Jayavsingh30/coil-winding-machine/Documentation/WhatsApp Image 2025-05-26 at 00.51.20_356be0d4.jpg

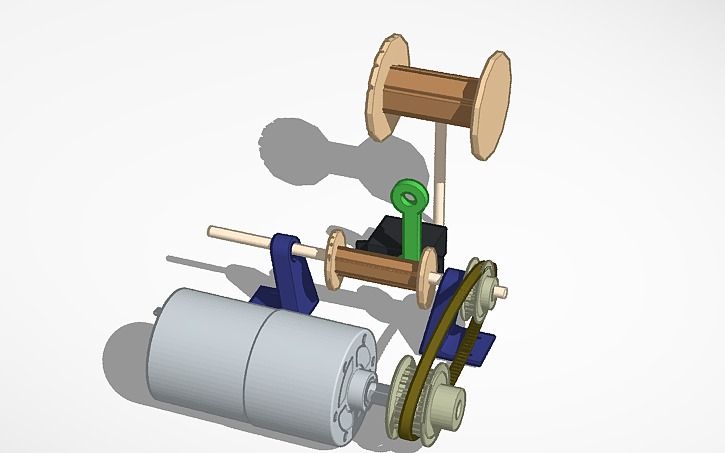
Documentation/WhatsApp Image 2025-05-26 at 00.51.20_356be0d4.jpg
