Jayavsingh30/coil-winding-machine/README.md

# coil-winding-machine
DIY automated coil winding machine with schematics, firmware, and documentation
