Jayavsingh30/coil-winding-machine/Documentation/Coil_Winding_Machine.pdf

# COIL WINDING MACHINE

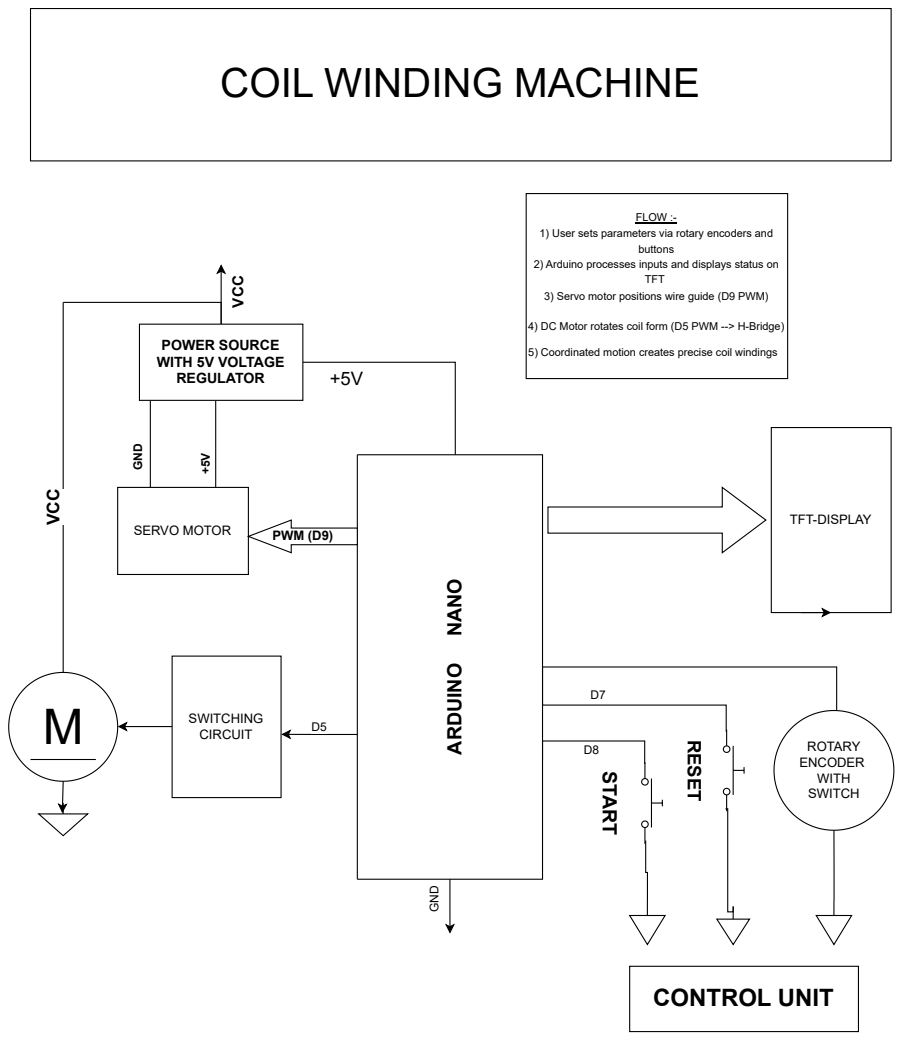
[picture p2: page 1]
GND; UIN; TFT-DISPLAY; SWITCHING CIRCUIT; VCC; SERVO MOTOR; PWM (D9); RESET; START; ROTARY ENCODER WITH SWITCH; CONTROL UNIT; POWER SOURCE WITH 5V VOLTAGE REGULATOR; FLOW :-; buttons; TFT

1) User sets parameters via rotary encoders and

2) Arduino processes inputs and displays status on

3) Servo motor positions wire guide (D9 PWM)

4) DC Motor rotates coil form (D5 PWM --> H-Bridge)

5) Coordinated motion creates precise coil windings

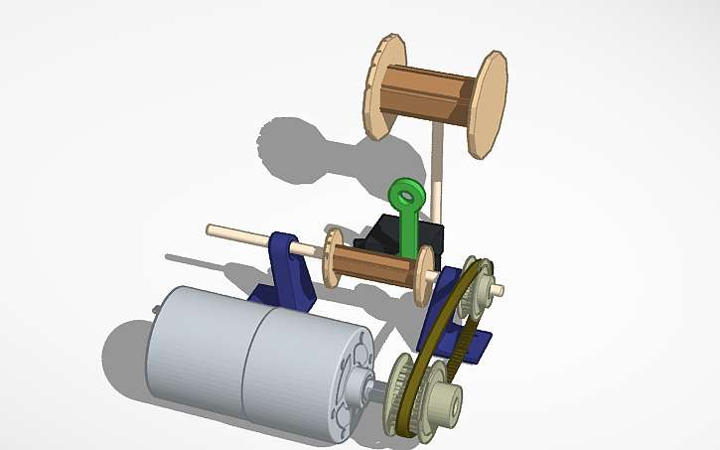
[picture p3: figure]
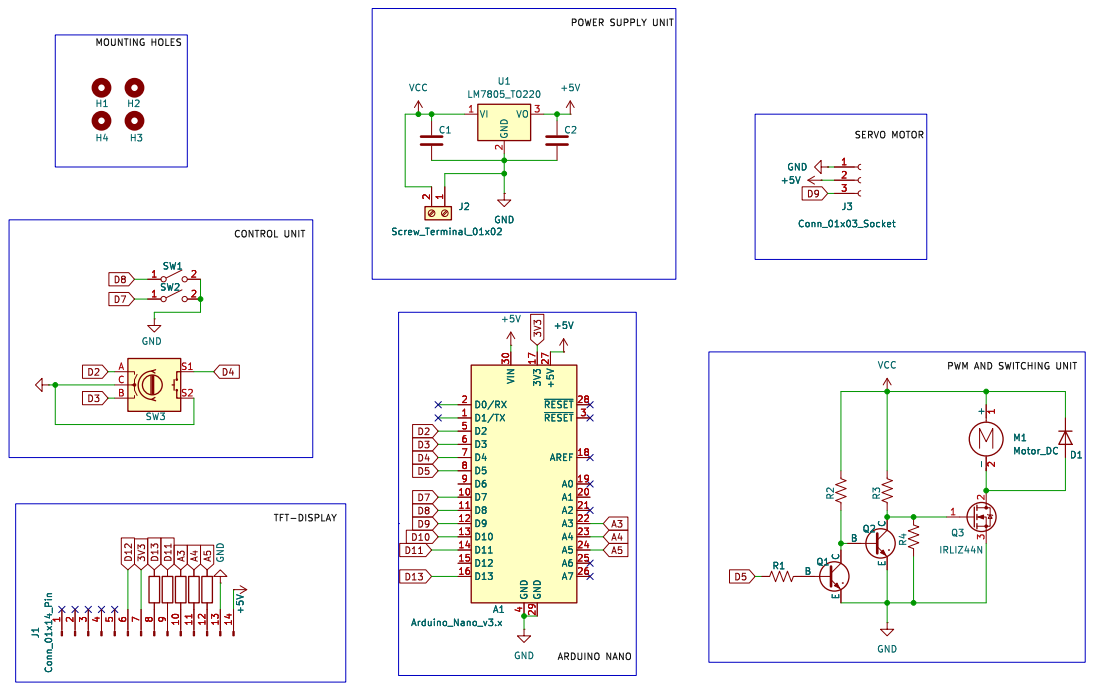
[picture p4: page 3]

## Bill of Materials (BOM)

Project: Coil Winding Machine | Date: 2025-05-26 | Revision: Rev. 1.0

### Section A - Mechanical Components

Sr. No | Part Name | Qty | Specification / Details | Notes
M1 | DC Motor | 1 | 775 DC Motor, 12-24V, 10000 RPM | Shaft: 5mm
M2 | Servo Motor | 1 | MG996R, 180deg Range, 15kg-cm | For lateral positioning
M3 | MDF Board | 1 | 11mm thick | Base structure
M4 | Timing Pulley (Motor) | 1 | 5mm bore, GT2 type | Mounted on 775 shaft
| | | 5mm bore, GT2 type
M5 | Timing Pulley (Load) | 1 | | Attached to winding mechanism
M6 | Timing Belt | 1 | GT2, 100mm length, 6mm width | Matches 20T-40T pulley combo
M7 | Ball Bearings | 2 | ID: 5mm, OD: 17mm, Width: 5mm | Deep groove type

### Section B - Electronics Components

Sr. No | Part Name | Qty | Specification / Details | Notes
E1 | Microcontroller | 1 | Arduino Nano (CH340 or ATmega328p) | Main control board
E2 | Custom PCB | 1 | Single-layer, 7050 mm | Hosts power, logic, and I/O
E3 | TFT Display | 1 | 2.8-inch SPI TFT, 240320 res | CS:A5, RESET:A4, DC:A3
E4 | Push Buttons | 2 | Tactile push buttons | For input controls
E5 | Rotary Encoder | 1 | With push button, D-shaft | Navigation + selection
E6 | MOSFET | 1 | IRF540N or equivalent | Controls DC motor via PWM
E7 | Transistors | 2 | NPN type | For motor control
E8 | Capacitors | 10 | 100nF, 10uF, 470uF (mix) | Filtering and stability
E9 | Resistors | 10 | 220Ohm, 1kOhm, 10kOhm (mix) | Pull-up/down and limiting
E10 | Diodes | 4 | 1N4007 | Flyback protection
| | | LM7805
E11 | Voltage Regulator | 1 | Power to logic and modules
