Jayavsingh30/coil-winding-machine/Hardware/Pcb/coil_winding_v1/coil_winding_step.pdf

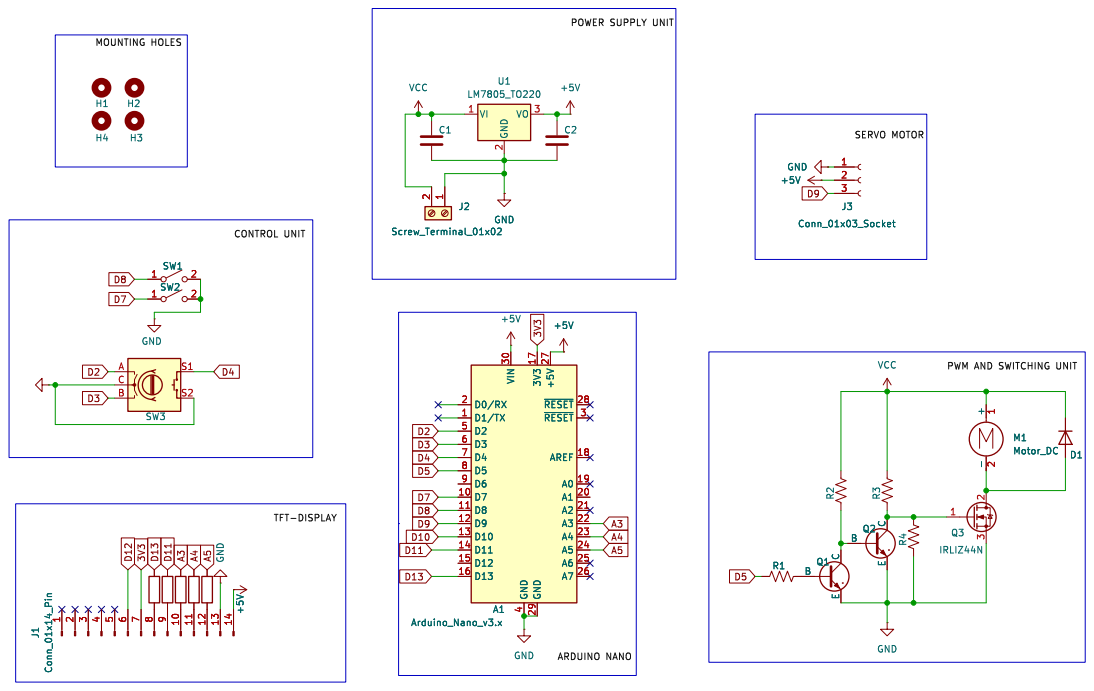
[picture p5: page 1]
