Jayavsingh30/coil-winding-machine/Hardware/Pcb/coil_winding_v3/compact/compact (2).kicad_pcb

## KiCad design Hardware/Pcb/coil_winding_v3/compact/compact (2).kicad_pcb (2025-06-27)

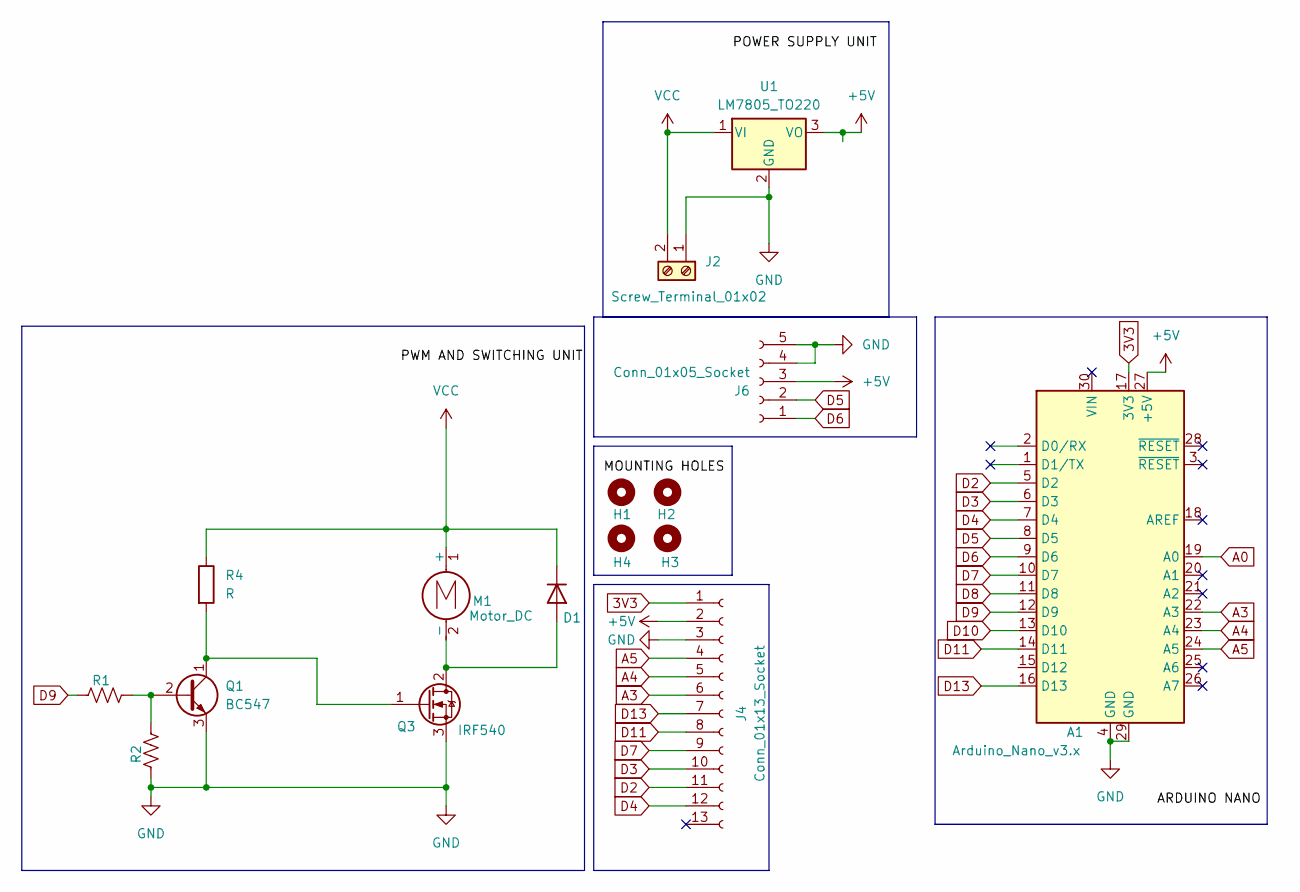
[picture p6: schematic compact (2).kicad_sch, COIL WINDING MACHINE]

Parts:
A1: Arduino_Nano_v3.x; Arduino_Nano
D1: D; D_DO-41_SOD81_P12.70mm_Horizontal
H1, H2, H3, H4: MountingHole; MountingHole_4mm
J2: Screw_Terminal_01x02; TerminalBlock_4Ucon_1x02_P3.50mm_Horizontal
J4: Conn_01x13_Socket; PinHeader_2x13_P2.54mm_Vertical
J6: Conn_01x05_Socket; PinHeader_2x05_P2.54mm_Vertical
M1: Motor_DC; TerminalBlock_4Ucon_1x02_P3.50mm_Horizontal
Q1: BC547; TO-92_Inline
Q3: IRF540; TO-220F-3_Vertical
R1: 220; R_Axial_DIN0207_L6.3mm_D2.5mm_P7.62mm_Horizontal
R2: 10K; R_Axial_DIN0207_L6.3mm_D2.5mm_P7.62mm_Horizontal
R4: R; R_Axial_DIN0207_L6.3mm_D2.5mm_P7.62mm_Horizontal
U1: LM7805_TO220; TO-220-3_Vertical

Connections:
3V3: A1.17 (3V3), J4.1
+5V: A1.27 (+5V), J4.2, J6.3, U1.3 (VO)
A0: A1.19 (A0)
A3: A1.22 (A3), J4.6
A4: A1.23 (A4), J4.5
A5: A1.24 (A5), J4.4
D2: A1.5 (D2), J4.11
D3: A1.6 (D3), J4.10
D4: A1.7 (D4), J4.12
D5: A1.8 (D5), J6.2
D6: A1.9 (D6), J6.1
D7: A1.10 (D7), J4.9
D8: A1.11 (D8)
D9: A1.12 (D9), R1.1
D10: A1.13 (D10)
D11: A1.14 (D11), J4.8
D13: A1.16 (D13), J4.7
GND: A1.4 (GND), A1.29 (GND), J2.1, J4.3, J6.4, J6.5, Q1.3 (E), Q3.3 (S), R2.1, U1.2 (GND)
unnamed: D1.2 (A), M1.2 (-), Q3.2 (D)
unnamed: Q1.2 (B), R1.2, R2.2
unnamed: Q1.1 (C), Q3.1 (G), R4.2

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
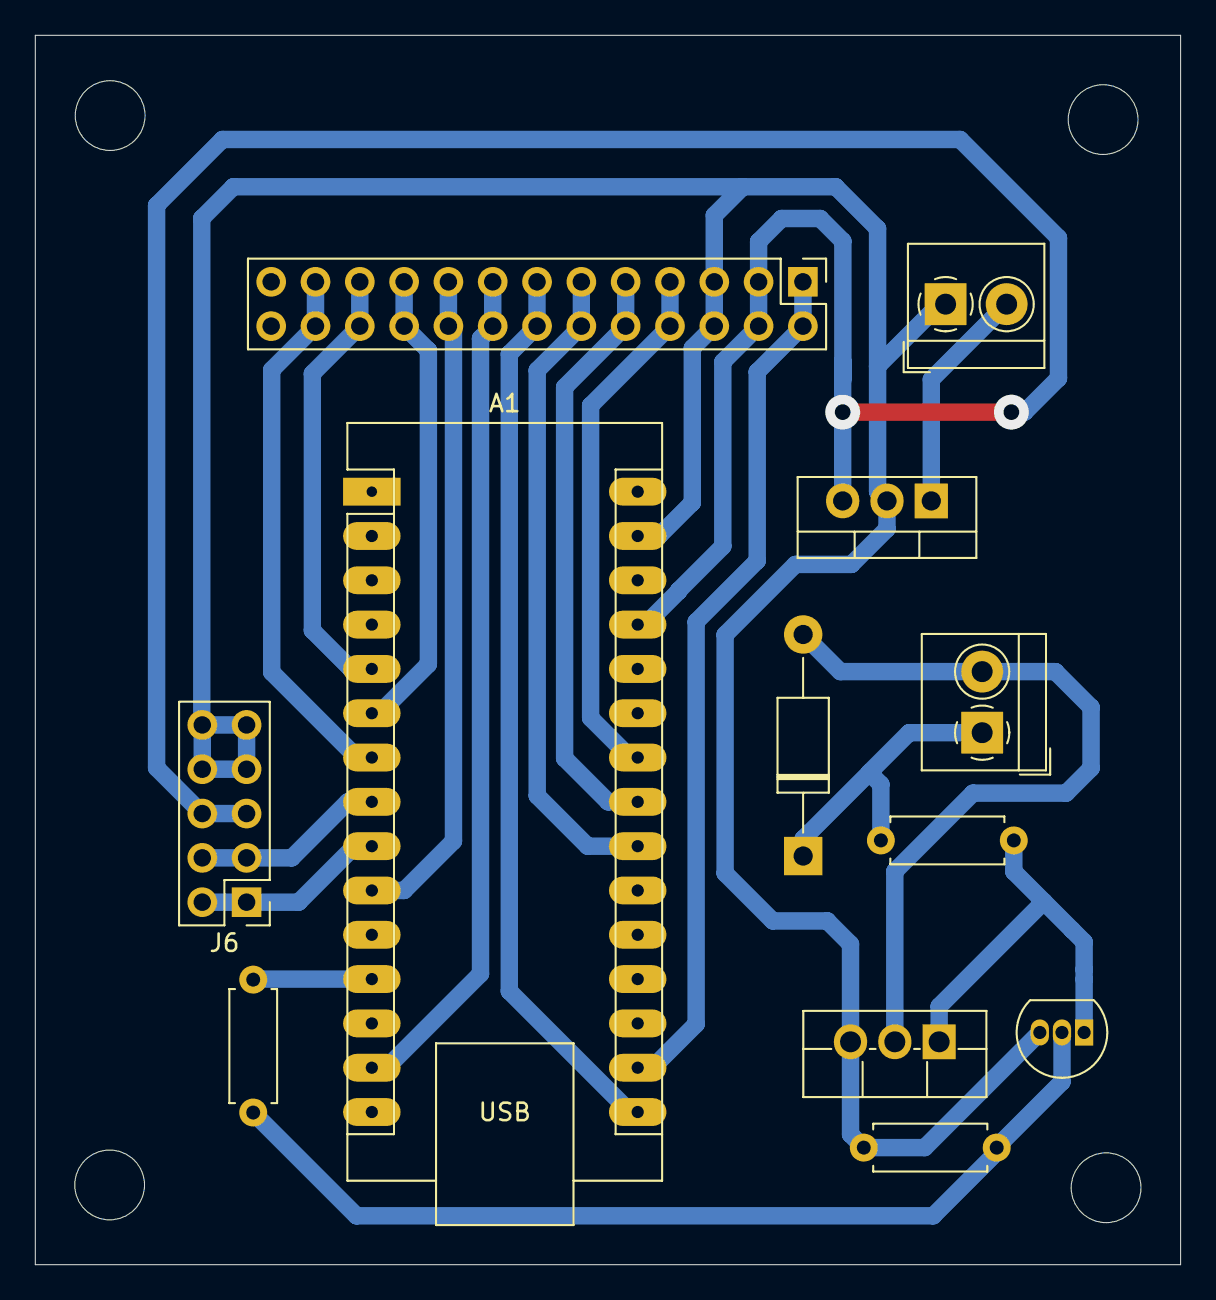
[picture p7: board compact (2).kicad_pcb from above]

Board: 2 copper layers, 65.7 x 70.5 mm, 16 parts (0 on the bottom side), 20 nets.
