Jayavsingh30/coil-winding-machine/Hardware/Pcb/coil_winding_v3/sensor/sensors/sensors.kicad_pcb

## KiCad design Hardware/Pcb/coil_winding_v3/sensor/sensors/sensors.kicad_pcb (2025-06-27)

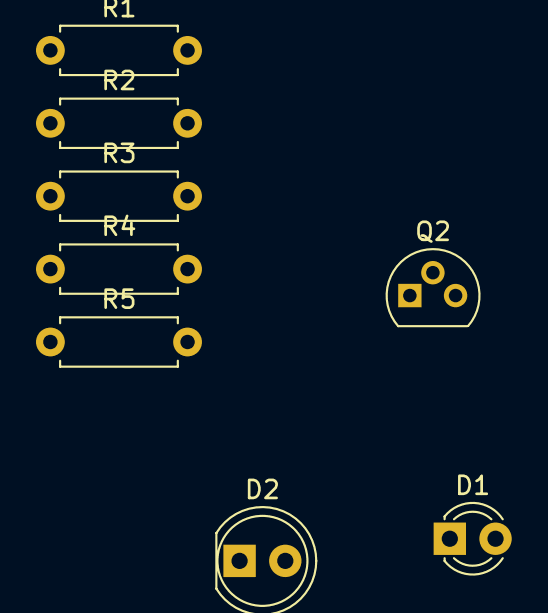
[picture p8: board sensors.kicad_pcb from above]

Board: 2 copper layers, 12 parts (0 on the bottom side), 7 nets, no tracks yet.

Parts:
D1: LED; LED_D3.0mm_Clear
D2: LED; LED_D5.0mm
H1, H2, H3, H4: MountingHole; MountingHole_3.2mm_M3
Q2: BC547; TO-92L
R1: 150; R_Axial_DIN0207_L6.3mm_D2.5mm_P7.62mm_Horizontal
R2: 2.2k; R_Axial_DIN0207_L6.3mm_D2.5mm_P7.62mm_Horizontal
R3, R4: 4.7k; R_Axial_DIN0207_L6.3mm_D2.5mm_P7.62mm_Horizontal
R5: 1k; R_Axial_DIN0207_L6.3mm_D2.5mm_P7.62mm_Horizontal

Connections:
+5V: D1.2 (A), R1.1, R3.1, R5.1
DETECT: R3.2, R4.1
GND: Q2.3 (E), R2.2
unnamed: D1.1 (K), R2.1
unnamed: D2.2 (A), R5.2
unnamed: D2.1 (K), Q2.1 (C)
unnamed: Q2.2 (B), R4.2
