Jayavsingh30/coil-winding-machine/Hardware/Pcb/coil_winding_v3/front_panel/front_panel.kicad_pcb

## KiCad design Hardware/Pcb/coil_winding_v3/front_panel/front_panel.kicad_pcb (2025-06-27)

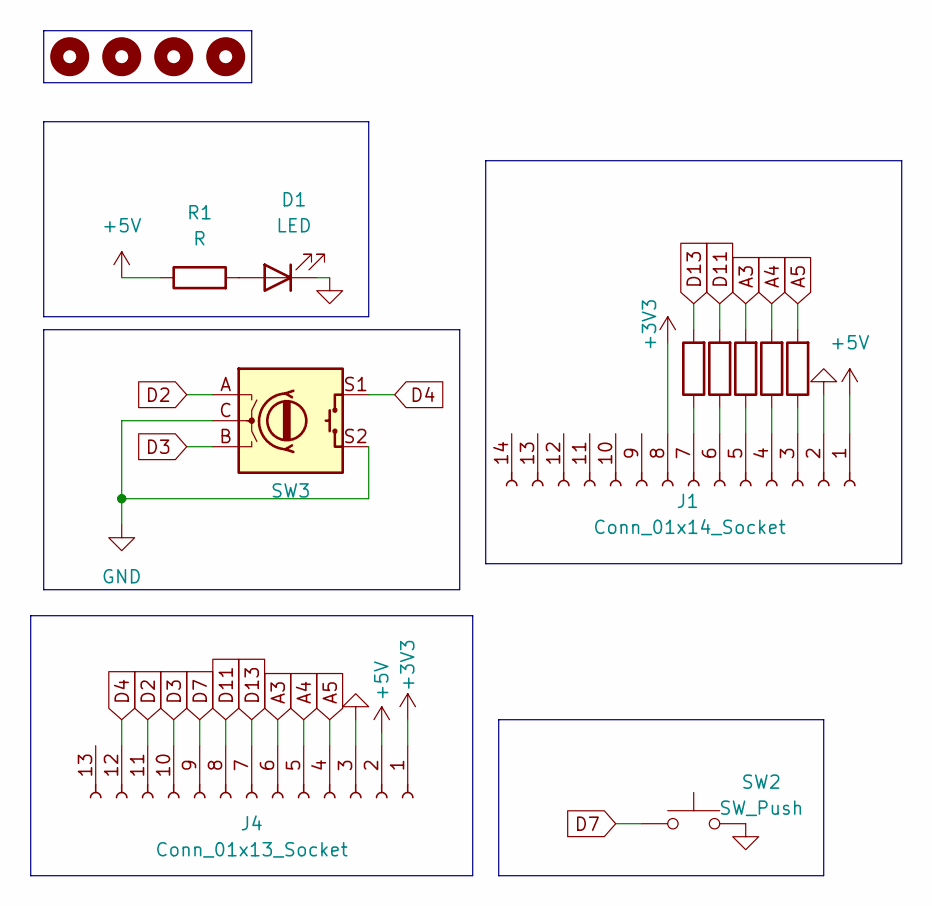
[picture p9: schematic front_panel.kicad_sch]

Parts:
D1: LED; LED_D5.0mm
H1, H2, H3, H4: MountingHole; MountingHole_3.2mm_M3
J1: Conn_01x14_Socket; PinSocket_1x14_P2.54mm_Vertical
J4: Conn_01x13_Socket; PinSocket_2x13_P2.54mm_Vertical
R1, R2, R3, R4, R6, R7: R; R_Axial_DIN0207_L6.3mm_D2.5mm_P7.62mm_Horizontal
SW2: SW_Push; SW_PUSH_6mm_H7.3mm
SW3: RotaryEncoder_Switch; RotaryEncoder_Alps_EC12E-Switch_Vertical_H20mm_CircularMoun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

Connections:
+3V3: J1.8, J4.1
+5V: J1.1, J4.2, R1.1
A3: J4.6, R4.2
A4: J4.5, R3.2
A5: J4.4, R2.2
D2: J4.11, SW3.A
D3: J4.10, SW3.B
D4: J4.12, SW3.S1
D7: J4.9, SW2.1
D11: J4.8, R7.2
D13: J4.7, R6.2
GND: D1.1 (K), J1.2, J4.3, SW2.2, SW3.C, SW3.S2
unnamed: D1.2 (A), R1.2
unnamed: J1.3, R2.1
unnamed: J1.4, R3.1
unnamed: J1.5, R4.1
unnamed: J1.6, R7.1
unnamed: J1.7, R6.1

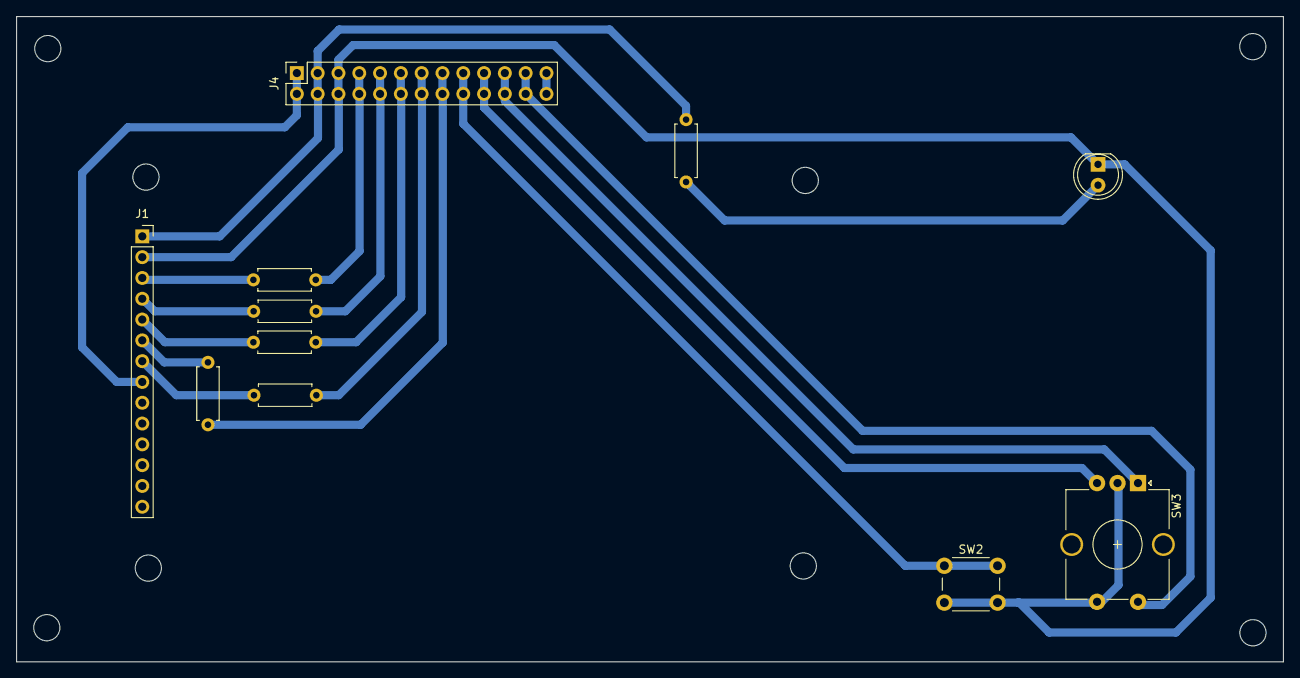
[picture p10: board front_panel.kicad_pcb from above]

Board: 2 copper layers, 154.7 x 78.8 mm, 19 parts (0 on the bottom side), 18 nets.

Other parts of the board:
H1#2, H1#3, H1#4, H1#5: MountingHole; MountingHole_3.2mm_M3
