Jayavsingh30/coil-winding-machine/Hardware/Pcb/coil_winding_v1/coil_winding_step.kicad_pcb

## KiCad design Hardware/Pcb/coil_winding_v1/coil_winding_step.kicad_pcb (2025-06-04, an earlier design)

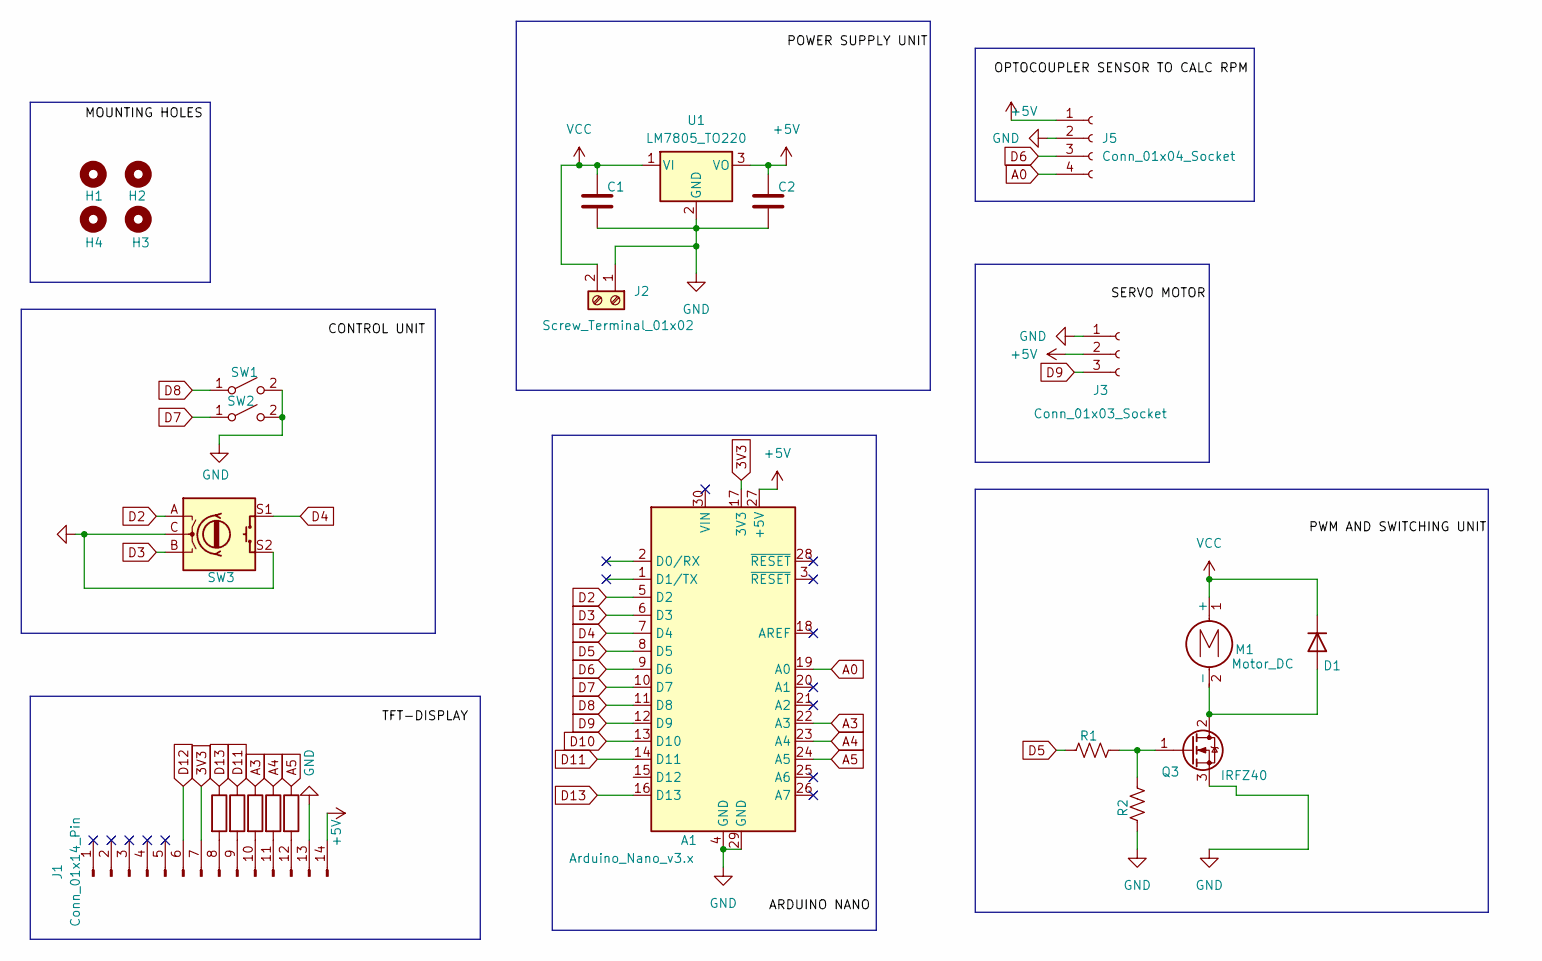
[picture p11: schematic coil_winding_step.kicad_sch, COIL WINDING MACHINE]

Parts:
A1: Arduino_Nano_v3.x; Arduino_Nano
C1, C2: C; CP_Radial_D5.0mm_P2.00mm
D1: D; D_DO-41_SOD81_P12.70mm_Horizontal
H1, H2, H3, H4: MountingHole; MountingHole_4mm
J1: Conn_01x14_Pin; PinSocket_1x14_P2.54mm_Vertical
J2: Screw_Terminal_01x02; BarrelJack_Horizontal
J3: Conn_01x03_Socket; PinSocket_1x03_P2.54mm_Vertical
J5: Conn_01x04_Socket; PinHeader_1x04_P2.54mm_Vertical
M1: Motor_DC; PinHeader_1x02_P2.54mm_Vertical
Q3: IRFZ40; TO-220F-3_Vertical
R1: 220; R_Axial_DIN0207_L6.3mm_D2.5mm_P7.62mm_Horizontal
R2: 10K; R_Axial_DIN0207_L6.3mm_D2.5mm_P7.62mm_Horizontal
R9, R10, R11, R12, R13: R; R_Axial_DIN0207_L6.3mm_D2.5mm_P7.62mm_Horizontal
SW1, SW2: SW_SPST; SW_PUSH_6mm_H7.3mm
SW3: RotaryEncoder_Switch; RotaryEncoder_Alps_EC12E-Switch_Vertical_H20mm
U1: LM7805_TO220; TO-220-3_Vertical

Connections:
3V3: A1.17 (3V3), J1.7
+5V: A1.27 (+5V), C2.1, J1.14, J3.2, J5.1, U1.3 (VO)
A0: A1.19 (A0), J5.4
A3: A1.22 (A3), R11.1
A4: A1.23 (A4), R10.1
A5: A1.24 (A5), R9.1
D2: A1.5 (D2), SW3.A
D3: A1.6 (D3), SW3.B
D4: A1.7 (D4), SW3.S1
D5: A1.8 (D5), R1.1
D6: A1.9 (D6), J5.3
D7: A1.10 (D7), SW2.1 (A)
D8: A1.11 (D8), SW1.1 (A)
D9: A1.12 (D9), J3.3
D10: A1.13 (D10)
D11: A1.14 (D11), R12.1
D12: J1.6
D13: A1.16 (D13), R13.1
GND: A1.4 (GND), A1.29 (GND), C1.2, C2.2, J1.13, J2.1, J3.1, J5.2, Q3.3 (S), R2.1, SW1.2 (B), SW2.2 (B), SW3.C, SW3.S2, U1.2 (GND)
unnamed: D1.2 (A), M1.2 (-), Q3.2 (D)
unnamed: J1.8, R13.2
unnamed: J1.9, R12.2
unnamed: J1.10, R11.2
unnamed: J1.11, R10.2
unnamed: J1.12, R9.2
unnamed: Q3.1 (G), R1.2, R2.2
VCC: C1.1, D1.1 (K), J2.2, M1.1 (+), U1.1 (VI)

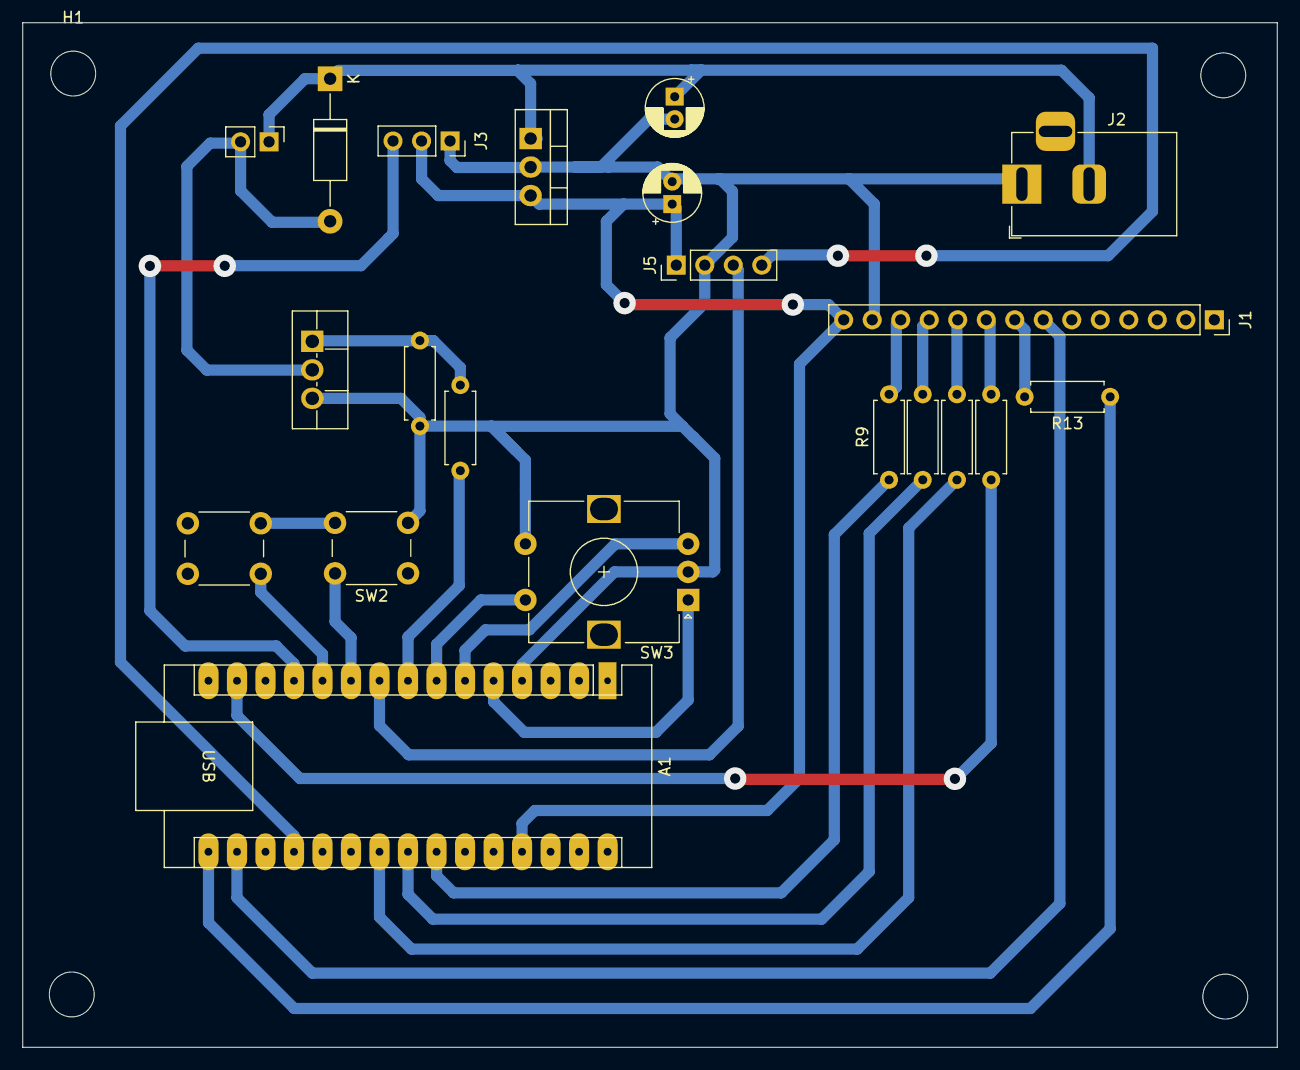
[picture p12: board coil_winding_step.kicad_pcb from above]

Board: 2 copper layers, 111.8 x 91.3 mm, 25 parts (0 on the bottom side), 25 nets.
