Jayavsingh30/coil-winding-machine/(commit log)

2025-05-22 Add KiCAD PCB project
    [coil_winding.kicad_pcb, coil_winding.kicad_sch, coil_winding_step.kicad_pcb, coil_winding_step.kicad_sch]
2025-05-22 Update version-2 PCB: modified tracks and footprint
    [coil_winding_step.kicad_pcb, coil_winding_step.kicad_sch]
2025-05-23 Changes made
    [coil_winding_step.kicad_pcb, coil_winding_step.kicad_sch]
2025-05-26 slight changes
    [coil_winding_step.csv, coil_winding_step.kicad_pcb]
